itsNairr/SAMI/deliverables/City of Kingston Presentation.pptx

## SAMI (Sidewalk Accessibility Monitoring and Inspection)

- October 14, 2026

Final Year Capstone

Chloe Cook, Toby Copeland, Hari Nair, and Hannah Vibien


## What is SAMI?

1. Unmanned, autonomous rover that navigates sidewalks and pathways in a set route
2. Primarily focus on detecting cracks and uneven elevation issues.


Autonomous navigation

Collision avoidance

Inspection and reporting

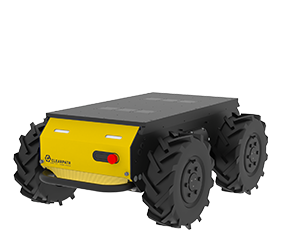
[picture p8: figure]
Husky Spec Comparison - Clearpath Robotics

## Overview of the Robot

Sensors:
- Huskey A200 Robot
- 2D SICK LiDAR
- RealSense depth camera (Front and Down)
- IMU (Inertial Measurement Unit)
- GPS
- Onboard computer
Features:
- Flag for visual awareness
- Speaker for audible awareness
- QR code for more information

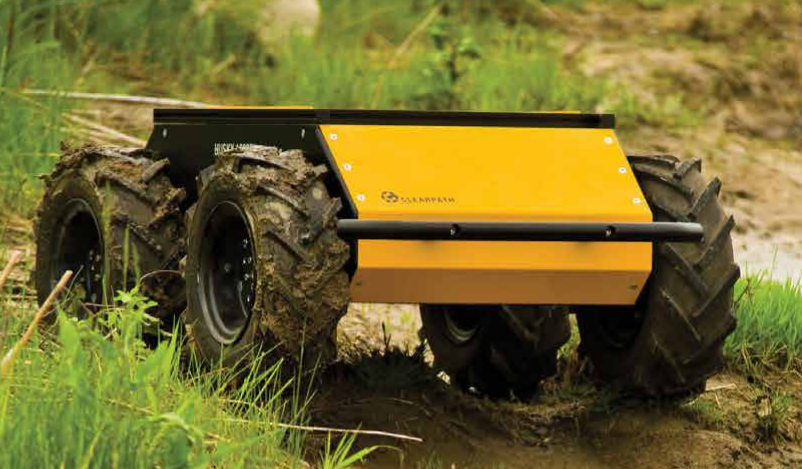
[picture p9: figure]

Does the City of Kingston track/save past workorders of sidewalk repair?
Is there any data we can use to test/train inspection camera?

## Current Inspection Priorities

Priority from Queen’s facilities
  - Cracks/Damage to sidewalks
  - Uneven elevation of sidewalk slabs
  - Damage to TWSI
  - Yearly check of Ramp elevation (after winter)
  - One time check of presence/dimensions of TWSI
  - One time check of width of pathways
  - One time check of presence of different materials along edges of paths and ramps

- What are the priorities of the City of Kingston?
- Are there any additional inspection items we have not considered?

## Reporting

Would overlaying data and GPS locations onto a map like this be useful? Or do you prefer a text file style of reporting?

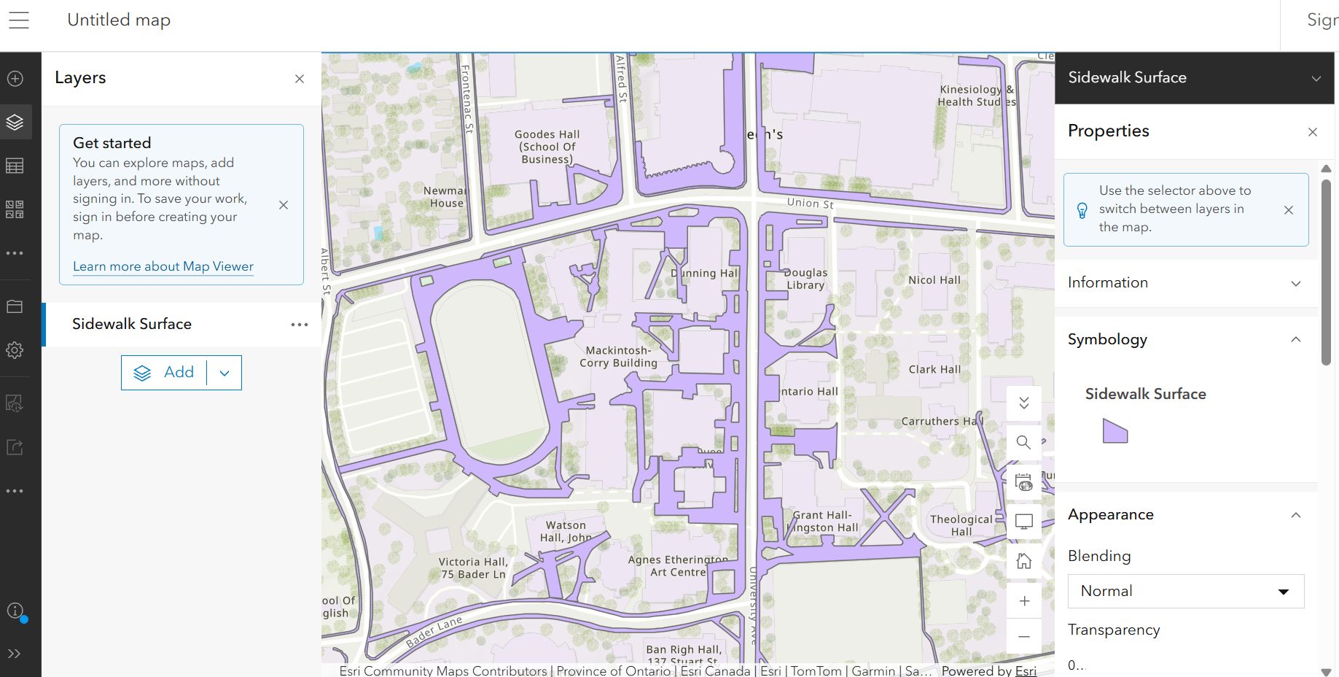
[picture p10: figure]

## Slide 6

## Overview of the Robot

- Huskey A200 Robot
- 2D SICK LiDAR
- RealSense depth camera (Front and down)
- IMU (Inertial Measurement Unit)
- GPS
- Onboard computer

## Navigation

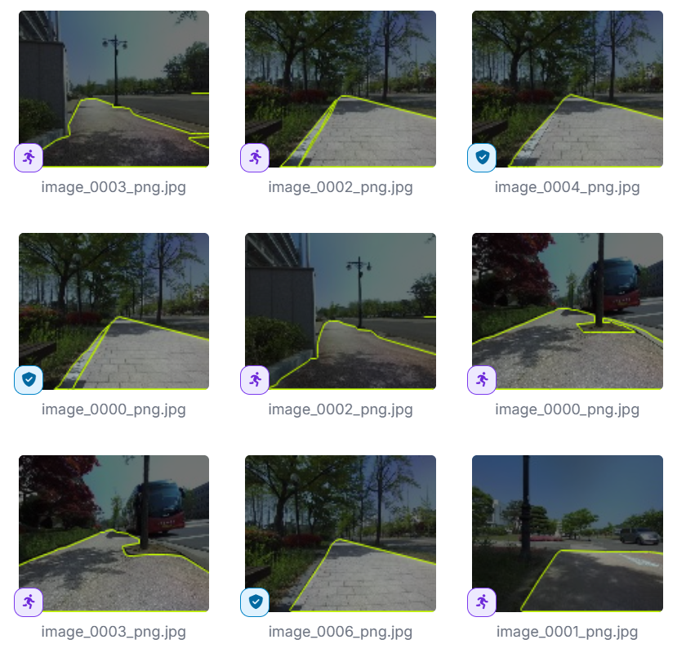
[picture p11: figure]

## Inspection System- Crack detection

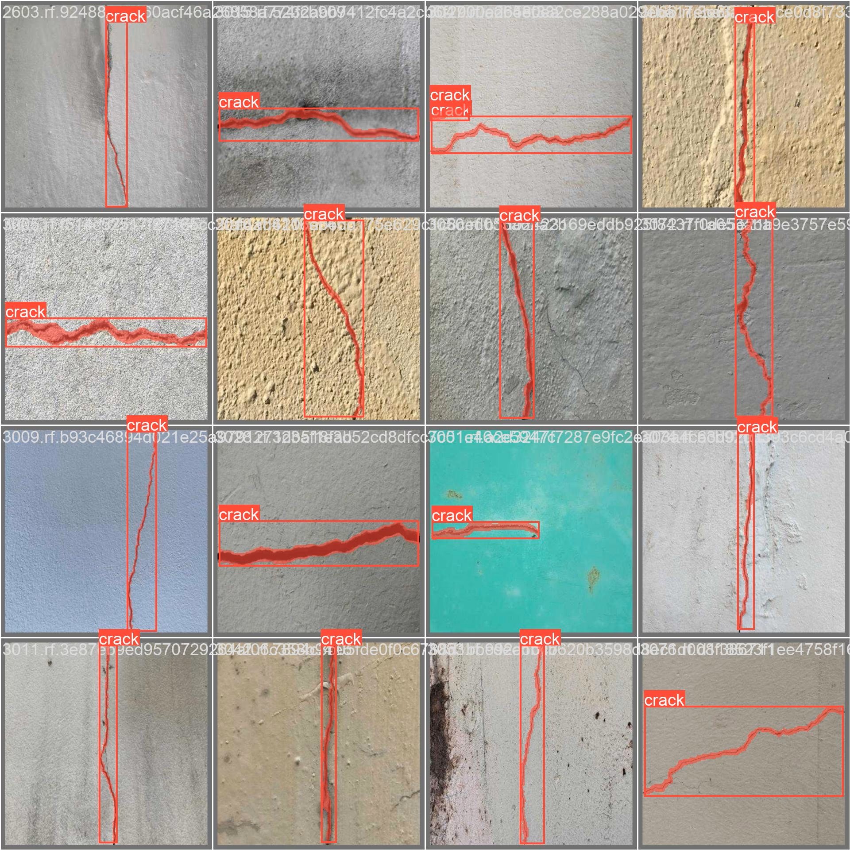
[picture p12: figure]
Crack segmentation dataset sample for infrastructure inspection

Mounted at 45* downwards facing

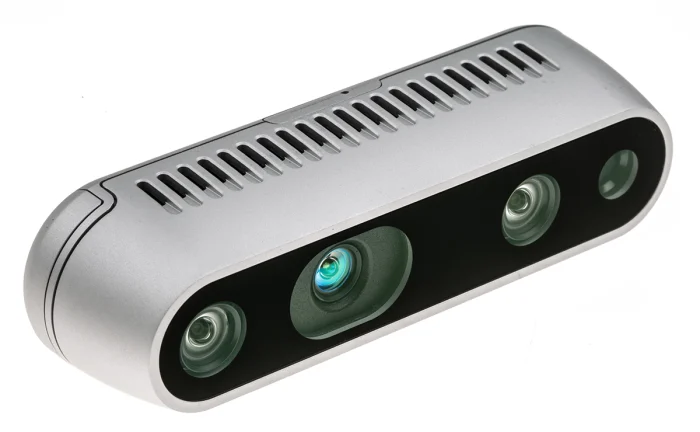
[picture p13: figure]
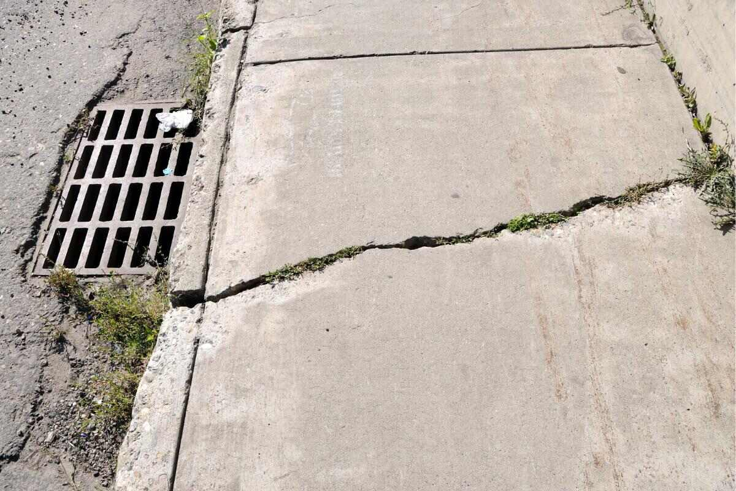
[picture p14: figure]

## Table Page

Tactic | Estimated Costs | Notes
Sub-category
Lorem ipsum dolor sit | $1,000.00 | Lorem ipsum dolor sit amet.
Lorem ipsum dolor sit | $1,000.00 | Lorem ipsum dolor sit amet, consectetur adipiscing elit, sed do eiusmod tempor incididunt ut labore et dolore magna aliqua.
Lorem ipsum dolor sit | $1,000.00 | Lorem ipsum dolor sit amet.
Lorem ipsum dolor sit | $1,000.00 | Lorem ipsum dolor sit amet.
Lorem ipsum dolor sit | $1,000.00 | Lorem ipsum dolor sit amet.
Lorem ipsum dolor sit | $1,000.00 | Lorem ipsum dolor sit amet, consectetur adipiscing elit, sed do eiusmod tempor incididunt ut labore et dolore magna aliqua.
Lorem ipsum dolor sit | $1,000.00 | Lorem ipsum dolor sit amet.
Subtotal | $9,000.00
15% fee | $1,350.00
Total | $10,350.00
