itsNairr/SAMI/notes/Goals Week 2.docx

# Goals

## Weekly

Look at simulations

Make scope and reach goals

Try and separate into sub roles

## Next week

Look into setting up testing area

# Mobility:

Get it to move

Move around and get back home (gps testy idk)

Navigate through non moving objects (lidar)

Navigate through dynamic objects (people)

Teach and repeat

# Vision:

Identify cracks

Distinguish between bad cracks and regular crack between 2 slabs

Identify ramp

D435 realsense

Navigation:

Identify the curbs

- Don’t drive off the curb
- Distinguish between like the curb when at intersection and elevation problem with curb

Path choice where should it go next

- Give it set gps locations to

Communication:

Store the problem locations locally

Send photos of problems with gps location back to a hub for facilities awareness

Update that map thing we found

Change in elevation of sidewalk – need to ask how much change is considered bad (accelerometer)

Assasibility problems

- Worn down markings at intersections (blind people?)
- Large cracks are tripping hazards
- Issues with ramps (closed, damage)
- Unexpected blockage on sidewalk (branches, boxes, garbage)

2d lidar or 3d?

Valedine

Sick lms111 he has 4 or 3 of those long range
