itsNairr/SAMI/notes/ClientMeetings/Sept 22 Accessibility Meeting.docx

Topics for meeting with Queen’s Facilities:

1. Explain our project, the purpose behind why we do capstone and what we want out the experience. Also that we need to create a scope.
2. Ask them to explain their job, so we can see how our project relates

Questions:

1. How do you determine if something on campus needs a repair?
2. Do you have a work order history, or any data on campus outdoor accessibility that could be useful for us?
3. What would you want to see in the scope for the project? What should we focus on?
4. Do you have a contact with the city of Kingston we could also talk too?

Meeting notes:

- Pathways, cracks in sidewalk, tactile strips, measure the length of tactile strip, level surfaces, debris (may not be able to fix it but can communicate it out to students)
- Paths that connect parking lots, and ramps incline (one time check) or once a year
- Priority pathways – will provide us with information
- Study done by geography students project, but observation based
- QFAS has standards we can use
- Most info comes in through email, they do not have a work order log
- Planning and renovation form, directed for issues and sidewalk issues
- There are different textures on the side of sidewalks and ramps
- Need it to be quite visible, add sound, and label on what it does
- QR code for more info on the Robot
- Robot insta account?
- Detecting snow in the winter? In case it does not get cleared out.
- Changes in elevation, what can get caught so cracks would be part of it.
- Crack→ cane could get stuck or wheels could get suck, or walkers
