itsNairr/SAMI/design/Mechanical/IntialConfiguationDrawingv1.png

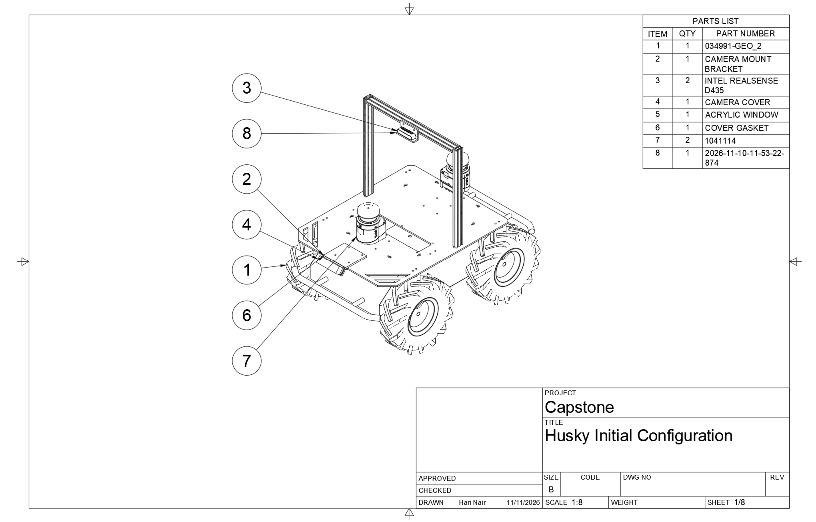
design/Mechanical/IntialConfiguationDrawingv1.png
