itsNairr/SAMI/deliverables/SAMIRiskRegister.xlsx

Sheet: EXAMPLE Risk Register
Risk Register Template Example
 |  |  |  |  |  |  | Auto-calculates
Risk ID | Risk | Risk Owner | Risk Trigger | Risk Category | Impact Level Rate 1 (LOW) to 5 (HIGH) | Probability Level Rate 1 (LOW) to 5 (HIGH) | Priority Level Impact x Probability Address the highest first. | Consequence Without Action | Positive Risk Response | Negative Risk Response | Response Trigger | Response Owner | Response Description | Expected Response | Status | Date Identified | Last Reviewed
RSK-001 | Delay in supplier shipment | Alexandra Mattson | Late delivery from the vendor | Operational | 4 | 4 | 16 | Missed client deadline | Enhance | Mitigate | Order delay notification | Brian Gorman | Reroute via alt distributor | Reduced project delay | Under Review | MM/DD/YY | MM/DD/YY
RSK-002 | Failure in a backup system | Aviv Perez | Weekly failover test | Technical | 4 | 4 | 16 | Outage during peak use | Share | Avoid | Test result report | Carmen Robertson | Switch to cloud redundancy | No downtime risk | Response in Progress | MM/DD/YY | MM/DD/YY
RSK-003 | Shift in market pricing | Brian Gorman | Competitor price drop | Strategic | 4 | 4 | 16 | Lost revenue margin | Exploit | Transfer | Pricing model trigger | Everett Crosse | Dynamic pricing algorithm | Gain on new accounts | Monitoring | MM/DD/YY | MM/DD/YY
RSK-004 | Lack of team certification | Brooklyn Jansen | Compliance audit finding | Compliance | 4 | 4 | 16 | Failed audit outcome | Accept | Accept | Quarterly audit report | Fiorella Fitzgerald | Schedule mandatory training | Certification compliance | Under Review | MM/DD/YY | MM/DD/YY
RSK-005 | A software update conflict | Carmen Robertson | Auto-patch failure | Technical | 4 | 4 | 16 | System freeze or rollback | Enhance | Transfer | Patch conflict log | Diana Kennedy | Isolate update in staging | Fewer incident reports | Response in Progress | MM/DD/YY | MM/DD/YY
RSK-006 | Inconsistent project estimates | Devon Gomez | Milestone planning gaps | Project | 4 | 4 | 16 | Timeline drift | Share | Mitigate | Scope change request | Alexandra Mattson | Implement the revised PERT method | Improved forecast | Under Review | MM/DD/YY | MM/DD/YY
RSK-007 | Contractor liability clause gap | Diana Kennedy | Contract review audit | Compliance | 4 | 4 | 16 | Uninsurable loss | Accept | Mitigate | Contract clause flagged | Aviv Perez | Legal review and reissue | Reduced legal exposure | Response in Progress | MM/DD/YY | MM/DD/YY
RSK-008 | No fallback for power outage | Everett Crosse | Generator servicing missed | Operational | 4 | 4 | 16 | Downtime in production | Enhance | Mitigate | Maintenance log | Hazel Christensen | Install a backup battery bank | Uptime maintained | Response in Progress | MM/DD/YY | MM/DD/YY
RSK-009 | Data sync error in reports | Fiorella Fitzgerald | ETL job failure | Technical | 4 | 4 | 16 | Incorrect business KPIs | Exploit | Avoid | Error threshold alert | Devon Gomez | Audit data pipeline | Accurate dashboards | Monitoring | MM/DD/YY | MM/DD/YY
RSK-010 | Unclear vendor responsibilities | Guadalupe Garcia | Multi-vendor project | Project | 4 | 4 | 16 | Gaps in service delivery | Accept | Accept | SLA mismatch alert | Henry McNeal | Align SOW with vendors | Higher accountability | Under Review | MM/DD/YY | MM/DD/YY
RSK-011 | A breach in access controls | Hazel Christensen | Role-based permissions gap | Cyber | 4 | 4 | 16 | User access violations | Accept | Mitigate | RBAC policy update | Brooklyn Jansen | Enforce privilege audit | Limit data exposure | Escalated | MM/DD/YY | MM/DD/YY
RSK-012 | Recurring absences from the team | Henry McNeal | Pattern in time logs | Operational | 4 | 4 | 16 | Delay in deliverables | Share | Transfer | HR absence report | Guadalupe Garcia | Adjust workload allocation | Output normalized | Closed | MM/DD/YY | MM/DD/YY
RSK-013 | Late internal approvals | Alexandra Mattson | Stalled decision point | Project | 4 | 4 | 16 | Missed the go-live milestone | Accept | Avoid | Change request aging | Fiorella Fitzgerald | Implement approval SLAs | Phase control gained | Monitoring | MM/DD/YY | MM/DD/YY
RSK-014 | Overage in the budget forecast | Aviv Perez | Forecast variance report | Strategic | 4 | 4 | 16 | Project pause or scope cut | Enhance | Mitigate | Budget update trigger | Diana Kennedy | Add a contingency buffer | Prevent overruns | Under Review | MM/DD/YY | MM/DD/YY
RSK-015 | Error in legal disclaimers | Brian Gorman | Final draft review | Compliance | 4 | 4 | 16 | Regulatory pushback | Accept | Mitigate | Legal signoff alert | Carmen Robertson | Rewrite disclaimers | Cleared before launch | Response in Progress | MM/DD/YY | MM/DD/YY
RSK-016 | Deviation from a safety plan | Brooklyn Jansen | Field inspection flag | Operational | 4 | 4 | 16 | On-site injury risk | Share | Mitigate | Safety form check | Hazel Christensen | Retrain crew lead | Lower incident rate | Response in Progress | MM/DD/YY | MM/DD/YY
RSK-017 | Out-of-date contact list | Carmen Robertson | Escalation issue | Operational | 4 | 4 | 16 | Slow incident response | Accept | Avoid | Failed contact test | Everett Crosse | Sync with HR records | Faster alerting | Closed | MM/DD/YY | MM/DD/YY
RSK-018 | Missed GDPR reconsent window | Devon Gomez | Policy update deadline | Compliance | 4 | 4 | 16 | Data breach penalties | Enhance | Transfer | Regulation deadline alert | Fiorella Fitzgerald | Deploy email reconsent | Lower legal risk | Escalated | MM/DD/YY | MM/DD/YY
RSK-019 | Use of deprecated toolset | Diana Kennedy | Legacy asset list | Technical | 4 | 4 | 16 | Security or feature gaps | Exploit | Mitigate | IT deprecation report | Brian Gorman | Shift to the supported version | Improved ops stability | Monitoring | MM/DD/YY | MM/DD/YY
RSK-020 | Duplicate data entry workflow | Everett Crosse | Form structure conflict | Operational | 4 | 4 | 16 | Processing delays | Enhance | Avoid | Data QA check | Guadalupe Garcia | Revise submission logic | Higher process speed | Response in Progress | MM/DD/YY | MM/DD/YY
RSK-021 | A high turnover rate | Fiorella Fitzgerald | Monthly HR report | Strategic | 4 | 4 | 16 | Project continuity gaps | Accept | Mitigate | Attrition threshold hit | Alexandra Mattson | Exit interview program | Lower churn | Identified | MM/DD/YY | MM/DD/YY
RSK-022 | Misaligned KPIs with partner | Guadalupe Garcia | Dashboard review | Strategic | 4 | 4 | 16 | Strained collaboration | Share | Mitigate | KPI sync session | Henry McNeal | Align metrics to objectives | Better reporting cohesion | Identified | MM/DD/YY | MM/DD/YY
RSK-023 | Broken escalation protocol | Hazel Christensen | Incident report feedback | Operational | 4 | 4 | 16 | Delayed resolution | Enhance | Accept | Escalation audit | Aviv Perez | Define roles in SOP | Streamlined handling | Response in Progress | MM/DD/YY | MM/DD/YY
RSK-024 | Lack of visibility into backlog | Henry McNeal | Sprint review outcome | Project | 4 | 4 | 16 | Under-scoped resource need | Share | Transfer | Ticket volume alert | Brooklyn Jansen | Improve backlog grooming | Better sprint flow | Monitoring | MM/DD/YY | MM/DD/YY
RSK-025 | License renewal window missed | Alexandra Mattson | Vendor billing cycle | Compliance | 4 | 4 | 16 | Suspended service use | Accept | Mitigate | Renewal deadline ping | Carmen Robertson | Centralize license tracker | Continuous access | Monitoring | MM/DD/YY | MM/DD/YY
RSK-026 | Outdated disaster recovery plan | Aviv Perez | Quarterly IT audit | Compliance | 4 | 4 | 16 | Failed continuity test | Accept | Avoid | DR policy review | Everett Crosse | Update response procedures | Reduced recovery lag | Monitoring | MM/DD/YY | MM/DD/YY
RSK-027 | The use of unapproved tools | Brooklyn Jansen | Shadow IT detection | Cyber | 4 | 4 | 16 | Data exfiltration risk | Share | Mitigate | Unauthorized app flag | Guadalupe Garcia | Create an approved tool registry | Increased security | Monitoring | MM/DD/YY | MM/DD/YY
RSK-028 | incomplete change request form | Carmen Robertson | Process deviation log | Operational | 4 | 4 | 16 | Rollback or delay | Enhance | Transfer | Form validation trigger | Alexandra Mattson | Add required field checks | Fewer rejections | Identified | MM/DD/YY | MM/DD/YY
RSK-029 | Missed stakeholder feedback | Diana Kennedy | Design review skipped | Project | 4 | 4 | 16 | Product misalignment | Exploit | Avoid | Feedback phase missed | Hazel Christensen | Add approval gate | Better user fit | Mitigation Complete | MM/DD/YY | MM/DD/YY
RSK-030 | Security log retention issue | Everett Crosse | SIEM alert for deletion | Cyber | 4 | 4 | 16 | Non-compliance with the audit | Accept | Accept | Log threshold alert | Brian Gorman | Increase the log window to 180 days | Meets retention standard | Response in Progress | MM/DD/YY | MM/DD/YY
RSK-031 | Limited mobile access to reports | Fiorella Fitzgerald | Field team complaint | Operational | 4 | 4 | 16 | Reduced field productivity | Enhance | Mitigate | Mobile access gap noted | Diana Kennedy | Optimize mobile dashboards | Improved responsiveness | Response in Progress | MM/DD/YY | MM/DD/YY
RSK-032 | Miscommunication in task assignment | Guadalupe Garcia | Conflicting instructions | Project | 4 | 4 | 16 | Rework and confusion | Share | Mitigate | Task reassignment log | Brooklyn Jansen | Implement task clarity SOP | Smoother handoffs | Response in Progress | MM/DD/YY | MM/DD/YY
RSK-033 | Unclear ownership in escalation | Hazel Christensen | Incident report review | Operational | 4 | 4 | 16 | Delayed recovery process | Accept | Transfer | Unclear escalation contact | Aviv Perez | Assign ownership tiers | Faster issue resolution | Identified | MM/DD/YY | MM/DD/YY
RSK-034 | An unverified vendor invoice | Henry McNeal | AP exception report | Compliance | 4 | 4 | 16 | Overpayment or fraud | Accept | Mitigate | Invoice not linked to PO | Carmen Robertson | Enforce 3-way match policy | Lower fraud risk | Escalated | MM/DD/YY | MM/DD/YY
RSK-035 | Underestimation of testing time | Alexandra Mattson | Sprint planning gap | Project | 4 | 4 | 16 | Missed delivery date | Enhance | Mitigate | Planning error in testing hours | Fiorella Fitzgerald | Add test padding in the timeline | On-time launches | Under Review | MM/DD/YY | MM/DD/YY
RSK-036 | Inaccurate tracking of expenses | Brian Gorman | Finance tool report | Strategic | 4 | 4 | 16 | Overspending risk | Accept | Avoid | Out-of-sync budget tool | Everett Crosse | Monthly reconciliation schedule | Tighter cost control | Under Review | MM/DD/YY | MM/DD/YY
RSK-037 | Lack of an escalation path in SOP | Brooklyn Jansen | Review of outdated doc | Operational | 4 | 4 | 16 | Resolution delay | Accept | Avoid | Missing contact info | Guadalupe Garcia | Update SOP with levels | Improved response speed | Identified | MM/DD/YY | MM/DD/YY
RSK-038 | The use of default system passwords | Diana Kennedy | Pen test finding | Cyber | 4 | 4 | 16 | Unauthorized access | Accept | Avoid | Default password detected | Alexandra Mattson | Enforce password policy | Reduced breach risk | Mitigation Complete | MM/DD/YY | MM/DD/YY
RSK-039 | A lack of onboarding documentation | Everett Crosse | New hire feedback | Operational | 4 | 4 | 16 | Slow ramp-up | Enhance | Accept | Onboarding checklist gap | Henry McNeal | Build quick-start docs | improved productivity | Identified | MM/DD/YY | MM/DD/YY
RSK-040 | Failure to back up the shared drive | Fiorella Fitzgerald | Backup alert email | Technical | 4 | 4 | 16 | Permanent data loss | Share | Mitigate | Backup skipped 3 days | Brian Gorman | Schedule daily cloud backups | Data recovery ensured | Identified | MM/DD/YY | MM/DD/YY
CLICK HERE TO CREATE IN SMARTSHEET (https://www.smartsheet.com/try-it?trp=12400)

Sheet: Scale and Key
RISK REGISTER SCALE
P R O B A B I L I T Y | 5 | 5 | 10 | 15 | 20 | 25 | Status | Positive Risk Response | Negative Risk Response | LEVEL
 | 4 | 4 | 8 | 12 | 16 | 20 | Identified | Accept | Accept | 1
 | 3 | 3 | 6 | 9 | 12 | 15 | Response in Progress | Enhance | Mitigate | 2
 | 2 | 2 | 4 | 6 | 8 | 10 | Mitigation Complete | Share | Transfer | 3
 | 1 | 1 | 2 | 3 | 4 | 5 | Monitoring | Exploit | Avoid | 4
 |  | 1 | 2 | 3 | 4 | 5 | Escalated |  |  | 5
 |  | I M P A C T |  |  |  |  | Closed
 |  |  |  |  |  |  | Under Review

Sheet: SAMI Risk Register
SAMI Risk Register
 |  |  |  |  |  |  | Auto-calculates
Risk ID | Risk | Risk Owner | Risk Trigger | Risk Category | Impact Level Rate 1 (LOW) to 5 (HIGH) | Probability Level Rate 1 (LOW) to 5 (HIGH) | Priority Level Impact x Probability Address the highest first. | Consequence Without Action | Positive Risk Response | Negative Risk Response | Response Trigger | Response Owner | Response Description | Expected Response | Status | Date Identified | Last Reviewed | KEY
1 | Collisions |  | YOLO doesn't identify a person with the front camera | Safety | 5 | 4 | 20 | Injury to pedestrians or property damage |  |  |  |  |  |  |  |  |  | LEVEL
2 | Losing path, being unable to return |  | Loss of GPS signal and IMU data and camera not being able to identify the path (GPS Multipath) | Technical | 5 | 3 | 15 |  |  |  |  |  |  |  |  |  |  | 1
3 | Water getting in electronics |  | Unexpected weather and/or water sources | Operational | 5 | 2 | 10 | Sensors and/or any electronics get damaged |  |  |  |  |  |  |  |  |  | 2
4 | Inaccurate Sensor Data |  | Latency or programmed incorrectly. Ex: truck casting shadow on a crack , looking twice or needing a percetnage threshold | Technical | 3 | 2 | 6 |  |  |  |  |  |  |  |  |  |  | 3
5 | Report corrupted |  |  | Technical |  |  |  | save copes in 2 spot and data backup |  |  |  |  |  |  |  |  |  | 4 | gps multipath
6 | Purposeful damage to the SAMI |  | Abused by public | Operational |  |  |  | Make community aware of positive benefits of SAMI |  |  | Make community aware of positive benefits of SAMI |  |  |  |  |  |  | 5
7 | Social protests against SAMI |  | Social/community rejection | Social | 3 | 3 | 9 | Speak to community in advance provide information
8 | Everyone gets sick |  | Virus | Operational | 4 | 1 | 4 | Work gets delayed and deadlines are missed
 |  |  | talk to community, talk to neighbourhood, have a public presence, enure that the purpuse is clear, we are trying to help improve humans space, not just take up there space like uber sidewalk robot s
 |  |  | be open to feedback from the community

Sheet: - Disclaimer -
Any articles, templates, or information provided by Smartsheet on the website are for reference only. While we strive to keep the information up to date and correct, we make no representations or warranties of any kind, express or implied, about the completeness, accuracy, reliability, suitability, or availability with respect to the website or the information, articles, templates, or related graphics contained on the website. Any reliance you place on such information is therefore strictly at your own risk.
