itsNairr/SAMI/design/Mechanical/IntelRealsense_D435_Multibody.SLDPRT

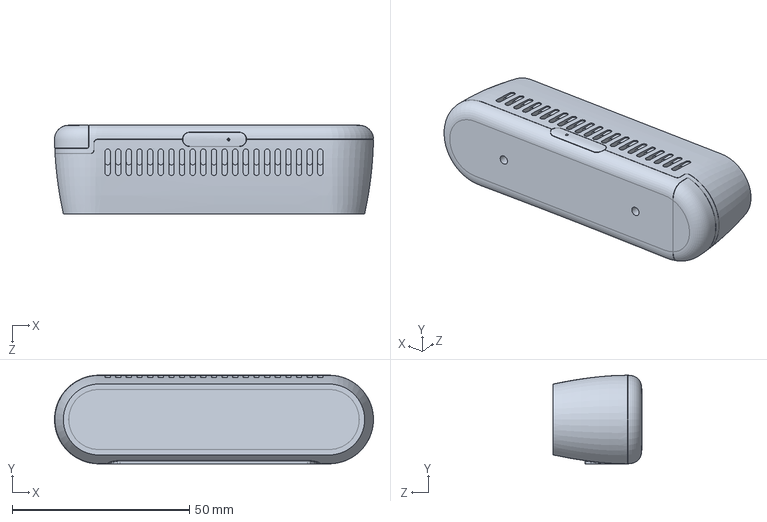
[picture p16: CAD file, 2026-11-12]
design/Mechanical/IntelRealsense_D435_Multibody.SLDPRT
90.0 x 25.0 x 25.0 mm
