itsNairr/SAMI/design/Mechanical/SICKLidar.stp

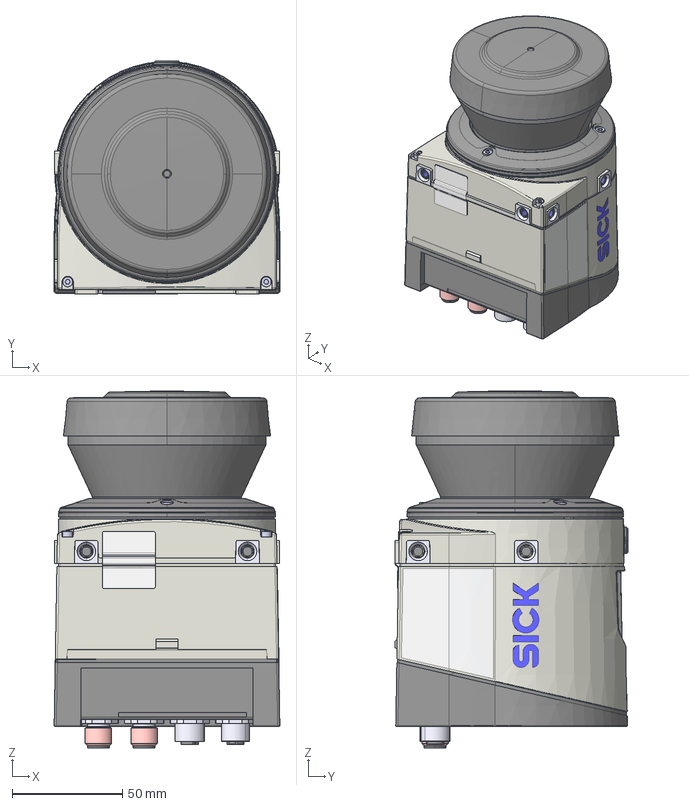
[picture p17: CAD file, 2026-11-12]
design/Mechanical/SICKLidar.stp
102.3 x 105.6 x 161.8 mm
