itsNairr/SAMI/design/Mechanical/HuskyA200.STEP

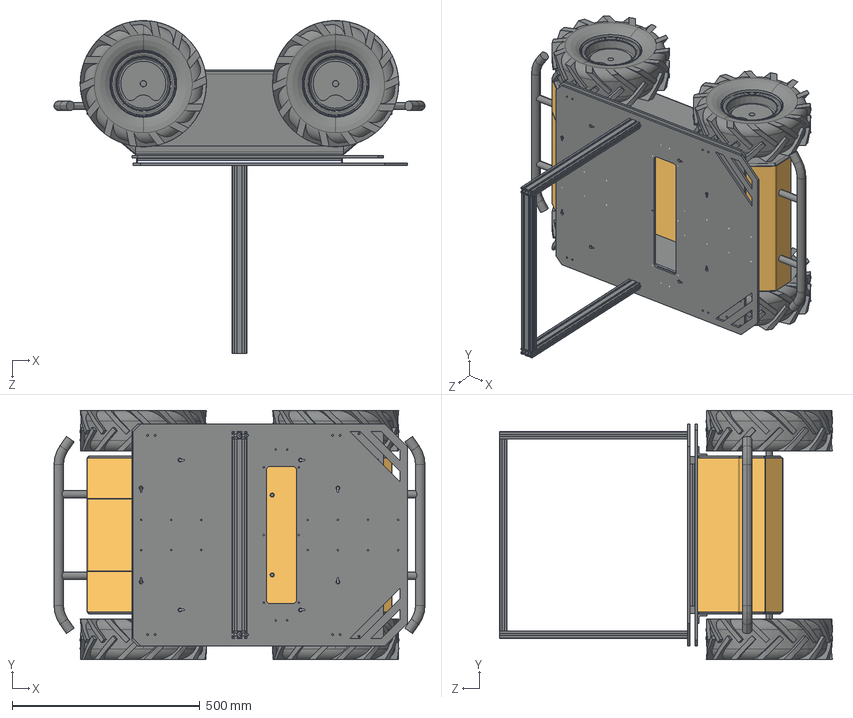
[picture p18: CAD file, 2026-11-05]
design/Mechanical/HuskyA200.STEP
987.4 x 663.0 x 885.8 mm
034991-CHASSIS_Simplified mCAD, STEP-Husky A200, Skid Steer
034991-LIVERY_Simplified mCAD, STEP-Husky A200, Skid Steer
034991-BUMPERS_Simplified mCAD, STEP-Husky A200, Skid Steer
034991-MOBILITY_Simplified mCAD, STEP-Husky A200, Skid Steer
034991-ELECTRONICS_Simplified mCAD, STEP-Husky A200, Skid Steer
034991-BATTERY_Simplified mCAD, STEP-Husky A200, Skid Steer
034991-TOP-PACS_Simplified mCAD, STEP-Husky A200, Skid Steer
034991-TOP-EXTRUSION_Simplified mCAD, STEP-Husky A200, Skid Steer
034991-TOP-STANDARD_Simplified mCAD, STEP-Husky A200, Skid Steer
