itsNairr/SAMI/Testing/Individual System/HuskyBase/Oct20RosCommandsHuskyConnection.docx

WSL USB COMMANDS

usbipd list

usbipd bind --busid 2-1

usbipd attach --wsl --busid 2-1

## Connecting to the robot:

source ~/ros2_ws/install/setup.bash #run once you open

cd ~/ros2_ws/src

git clone https://github.com/husky/husky.git -b humble-devel #run in src

cd ~/ros2_ws/src/husky/husky_description/urdf #go into file

dmesg | grep usb #use this to determine if USB0 or USB1

code . #open VSCode and change line 178 to dev/ttyUSB0</param> based on previous line

lsusb #display usb list WSL sees

cd ~/ros2_ws

colcon build #do before run in workspace (not in file)

sudo chmod 666 /dev/ttyUSB0 #connect to USB, or change to 1 if USB1

ros2 launch husky_base base.launch.py #launch program
