itsNairr/SAMI/Testing/Individual System/Simulation/Simulation.docx

# 1. Simulation Testing

## 1.1 Simulation Worlds

The current Gazebo simulation has been set up to use two different worlds for testing. The first is the Clearpath warehouse world which is used for testing sensors / sensor integration as well as driving with the safety stop object detection feature discussed below in section 1.2 Features. The second world includes a pier which is used due to its similarity to a sidewalk. This world is to be used for testing sidewalk and crack detecting model

## 1.2 Features

The current simulation features include keyboard control movement around the world, and object detection and stop using the forward facing camera. The forward camera uses depth to detect distance to an object and when it is within the given range it locks out the /cmd_vel ROS2 topic to remove drive access from the keyboard. This is done to test out stopping distances at different speeds.

## 1.3 Sensor Setup

The simulation to date includes two cameras, one facing 45 degrees downwards to detect and analyze cracks and one facing forward to detect obstructions and classify them. There is also a LiDAR connected to the top to view obstructions on a 2D plane. Inside the Husky there is also an IMU to determine orientation which is used for determining incline of sidewalks.

# 2. Future Steps

## 2.1 Worlds

Future steps for the worlds include creating a more realistic sidewalk world with real gaps to properly test crack detection.

## 2.2 Features

Camera node will be updated to match the current non simulation version of object person and person detection. This includes transferring the model the camera uses to detect when obstacle is a person. Future improvements to simulation should also include only preventing robot from moving forward when an obstacle is detected and allow it to move backwards otherwise it can get trapped in simulation.

## 2.3 Sensors

Future steps for the sensors include updating the current sensor positions. The simulation sensor positions are outdated and should be changed to match the current plan. The second LiDAR and GNSS, as well as their nodes should be added as well as their nodes to integrate them should be added as well.
