itsNairr/SAMI/Testing/Subsytems/Collision avoidance/Collision avoidance data 2026-11-11.xlsx

 |  | stopping distance was set to 0.5m in code.
speed (m/2) | stopping distance(m)
0.34 | 0.54
0.41 | 0.495
0.5 | 0.4066666667
0.61 | 0.3133333333 |  | 0.5 | 0.5
0.81 | 0.23 |  | 0 | 0.9
0.89 | hit the foam square could not get accurate measurements
differnce between expected and actual
0.04
-0.005 | -0.005
-0.09333333333 | -0.1
-0.1866666667 | -0.2
-0.27 | -0.3
Conclusion
As speed is increased by a factor of 10 the stopping distance multiplier must be increased by a factor of 10 as well to result in the expected stoping distance
