itsNairr/SAMI/Testing/Individual System/YOLOCrackDetection/November 10th Training & Test/results.csv

epoch | time | train/box_loss | train/seg_loss | train/cls_loss | train/l1_loss | train/sem_loss | metrics/precision(B) | metrics/recall(B) | metrics/mAP50(B) | metrics/mAP50-95(B) | metrics/precision(M) | metrics/recall(M) | metrics/mAP50(M) | metrics/mAP50-95(M) | val/box_loss | val/seg_loss | val/cls_loss | val/l1_loss | val/sem_loss | lr/pg0 | lr/pg1 | lr/pg2 | lr/pg3 | lr/pg4 | lr/pg5 | lr/pg6 | lr/pg7
1 | 93.4235 | 0.98665 | 1.73226 | 1.91144 | 0.01104 | 1.36668 | 0.86216 | 0.7241 | 0.78481 | 0.5495 | 0.86027 | 0.69755 | 0.75404 | 0.4273 | 1.31196 | 1.75532 | 1.30021 | 0.02474 | 0 | 0.00997015 | 0.00332338 | 0.00997015 | 0.00332338 | 0.00997015 | 0.00332338 | 0.00997015 | 0.00332338
2 | 160.187 | 0.97876 | 1.36418 | 0.92737 | 0.01131 | 0.76553 | 0.82601 | 0.67821 | 0.75132 | 0.48826 | 0.81385 | 0.67241 | 0.72413 | 0.40173 | 1.44727 | 1.47557 | 1.23525 | 0.03003 | 0 | 0.0198713 | 0.00662377 | 0.0198713 | 0.00662377 | 0.0198713 | 0.00662377 | 0.0198713 | 0.00662377
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
