itsNairr/SAMI/Testing/Individual System/YOLOCrackDetection/November 10th Training & Test/results.png

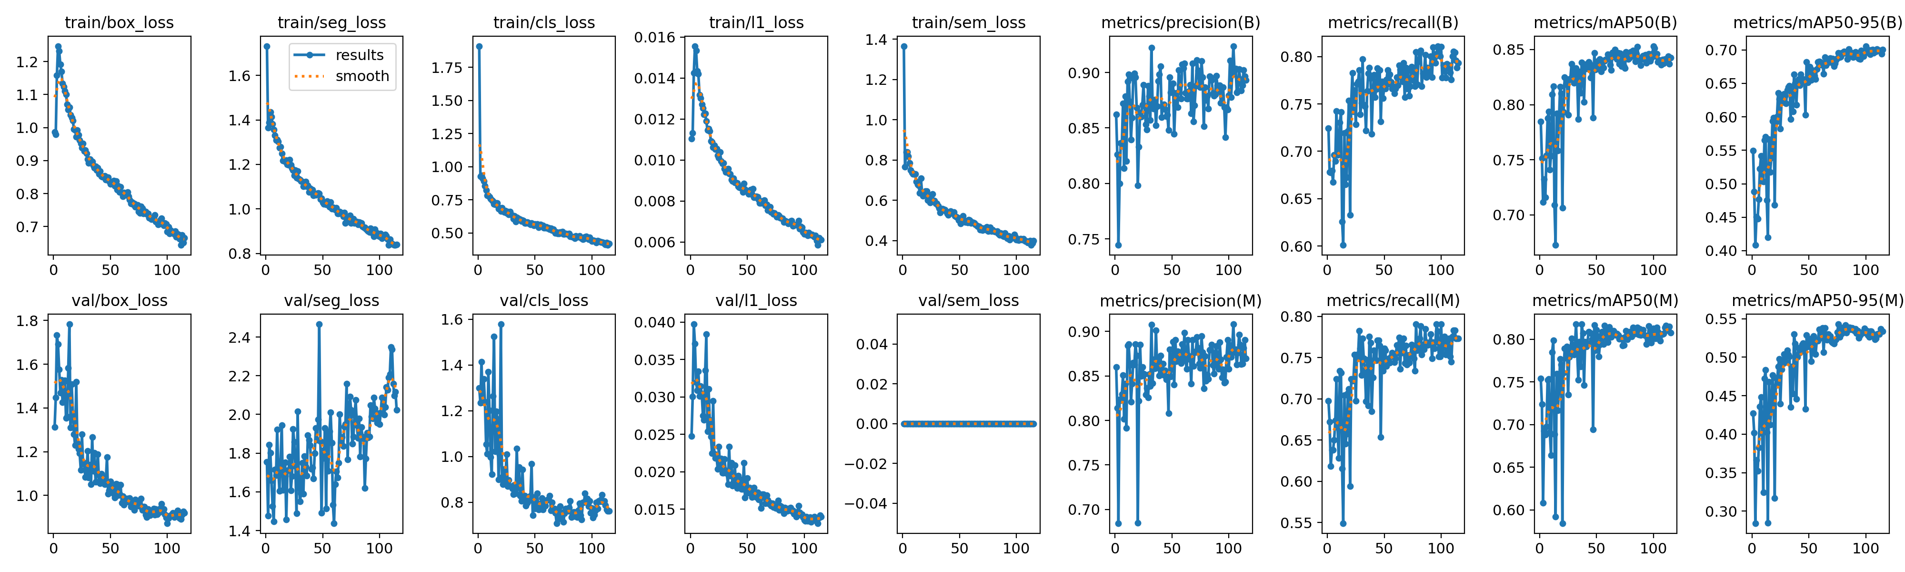
Testing/Individual System/YOLOCrackDetection/November 10th Training & Test/results.png
