itsNairr/SAMI/design/Electrical/PowerDistributionDiagramR1.pdf

31 | LIP.IE

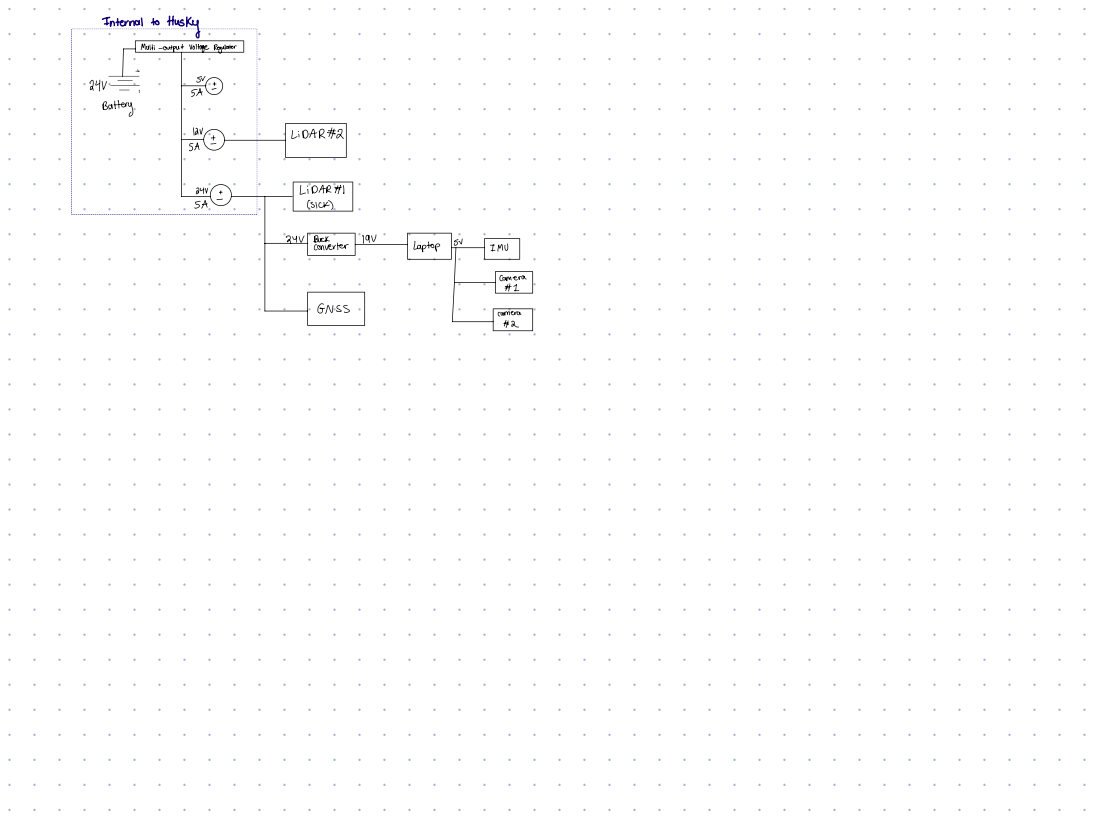
[picture p31: page 1]
Internal.itiitageresuator; battery; LIDAR 2; 24VByterter19V; Laptop so IMU; capyra; GNSS; carpet
