itsNairr/SAMI/design/Mechanical/InitialConfigCalculations.pdf

## Calculation Sheet

# Husky Downward Camera Mount

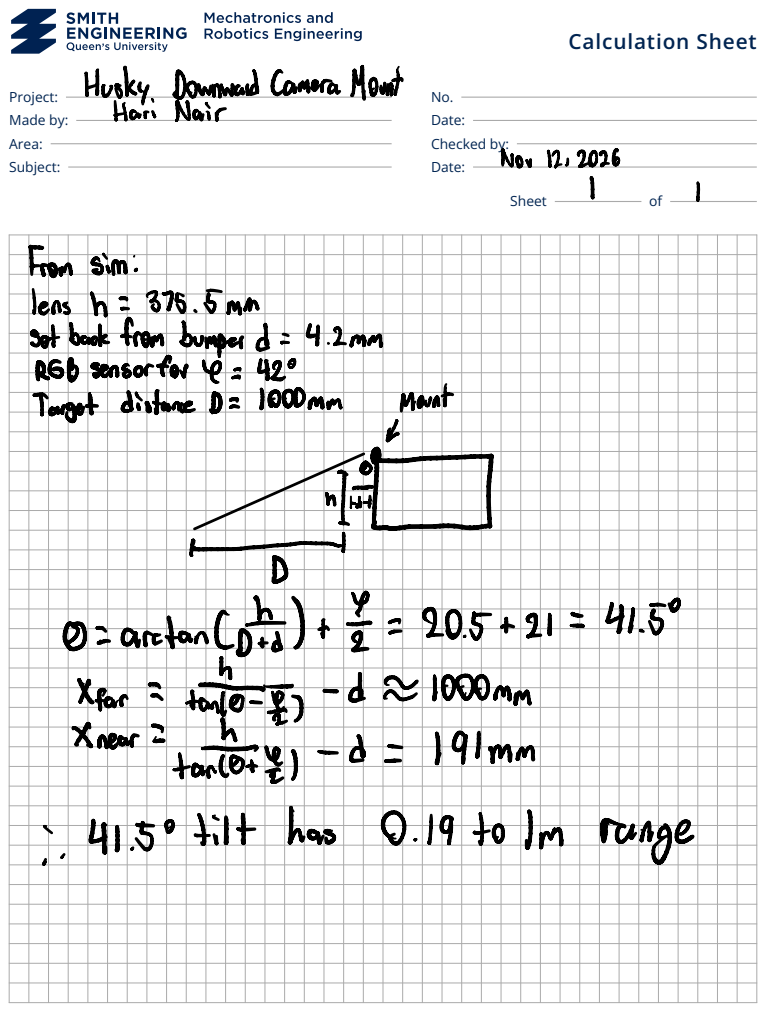
[picture p32: page 1]
Project:; Made by:; Date:; Area:; Checked by:; Subject:; Sheet; Hari Nair; Nov 12.; from; sim :; Xnear; tantox -; filt; has; range

lens | | h | = 375.5mm
set | back from | | | bumper d = | | | | 4 .2 mm
nT --1

&B | | sensorfor 4 | | | | : | 42
distance | | D = | | 1000mm | | | | Mount Target

O = arctan (0 | | | | | )芝 = | 20 | .5+ 2 に | 41 | .50

Xfar | : | fa-E-d¹⁰⁰⁰mm

## Calculation Sheet

# HuskyLidar Spaina

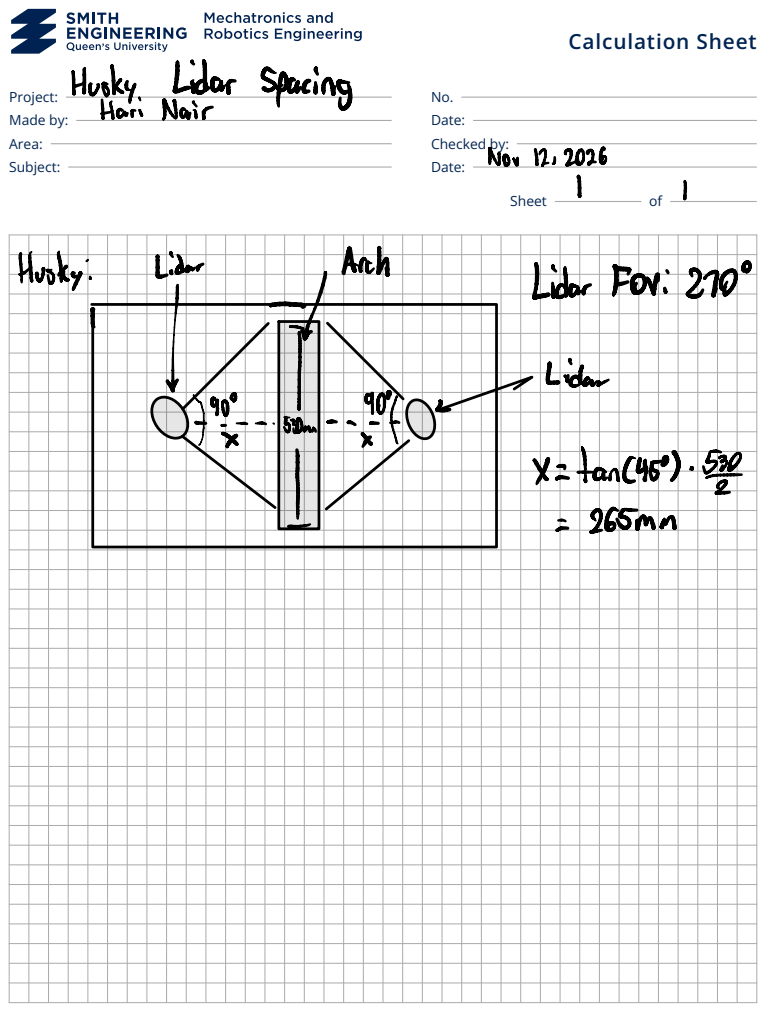
[picture p33: page 2]
Project:; Made by:; Date:; Area:; Checked by:; Subject:; Sheet; Nov 12.; Husky; Arch; Lidar; FOV:; ↳i-fncus.
