itsNairr/SAMI/Testing/Individual System/Camera/CameraDepthTesting_Sept25/CameraDepthTesterDrawing.pdf

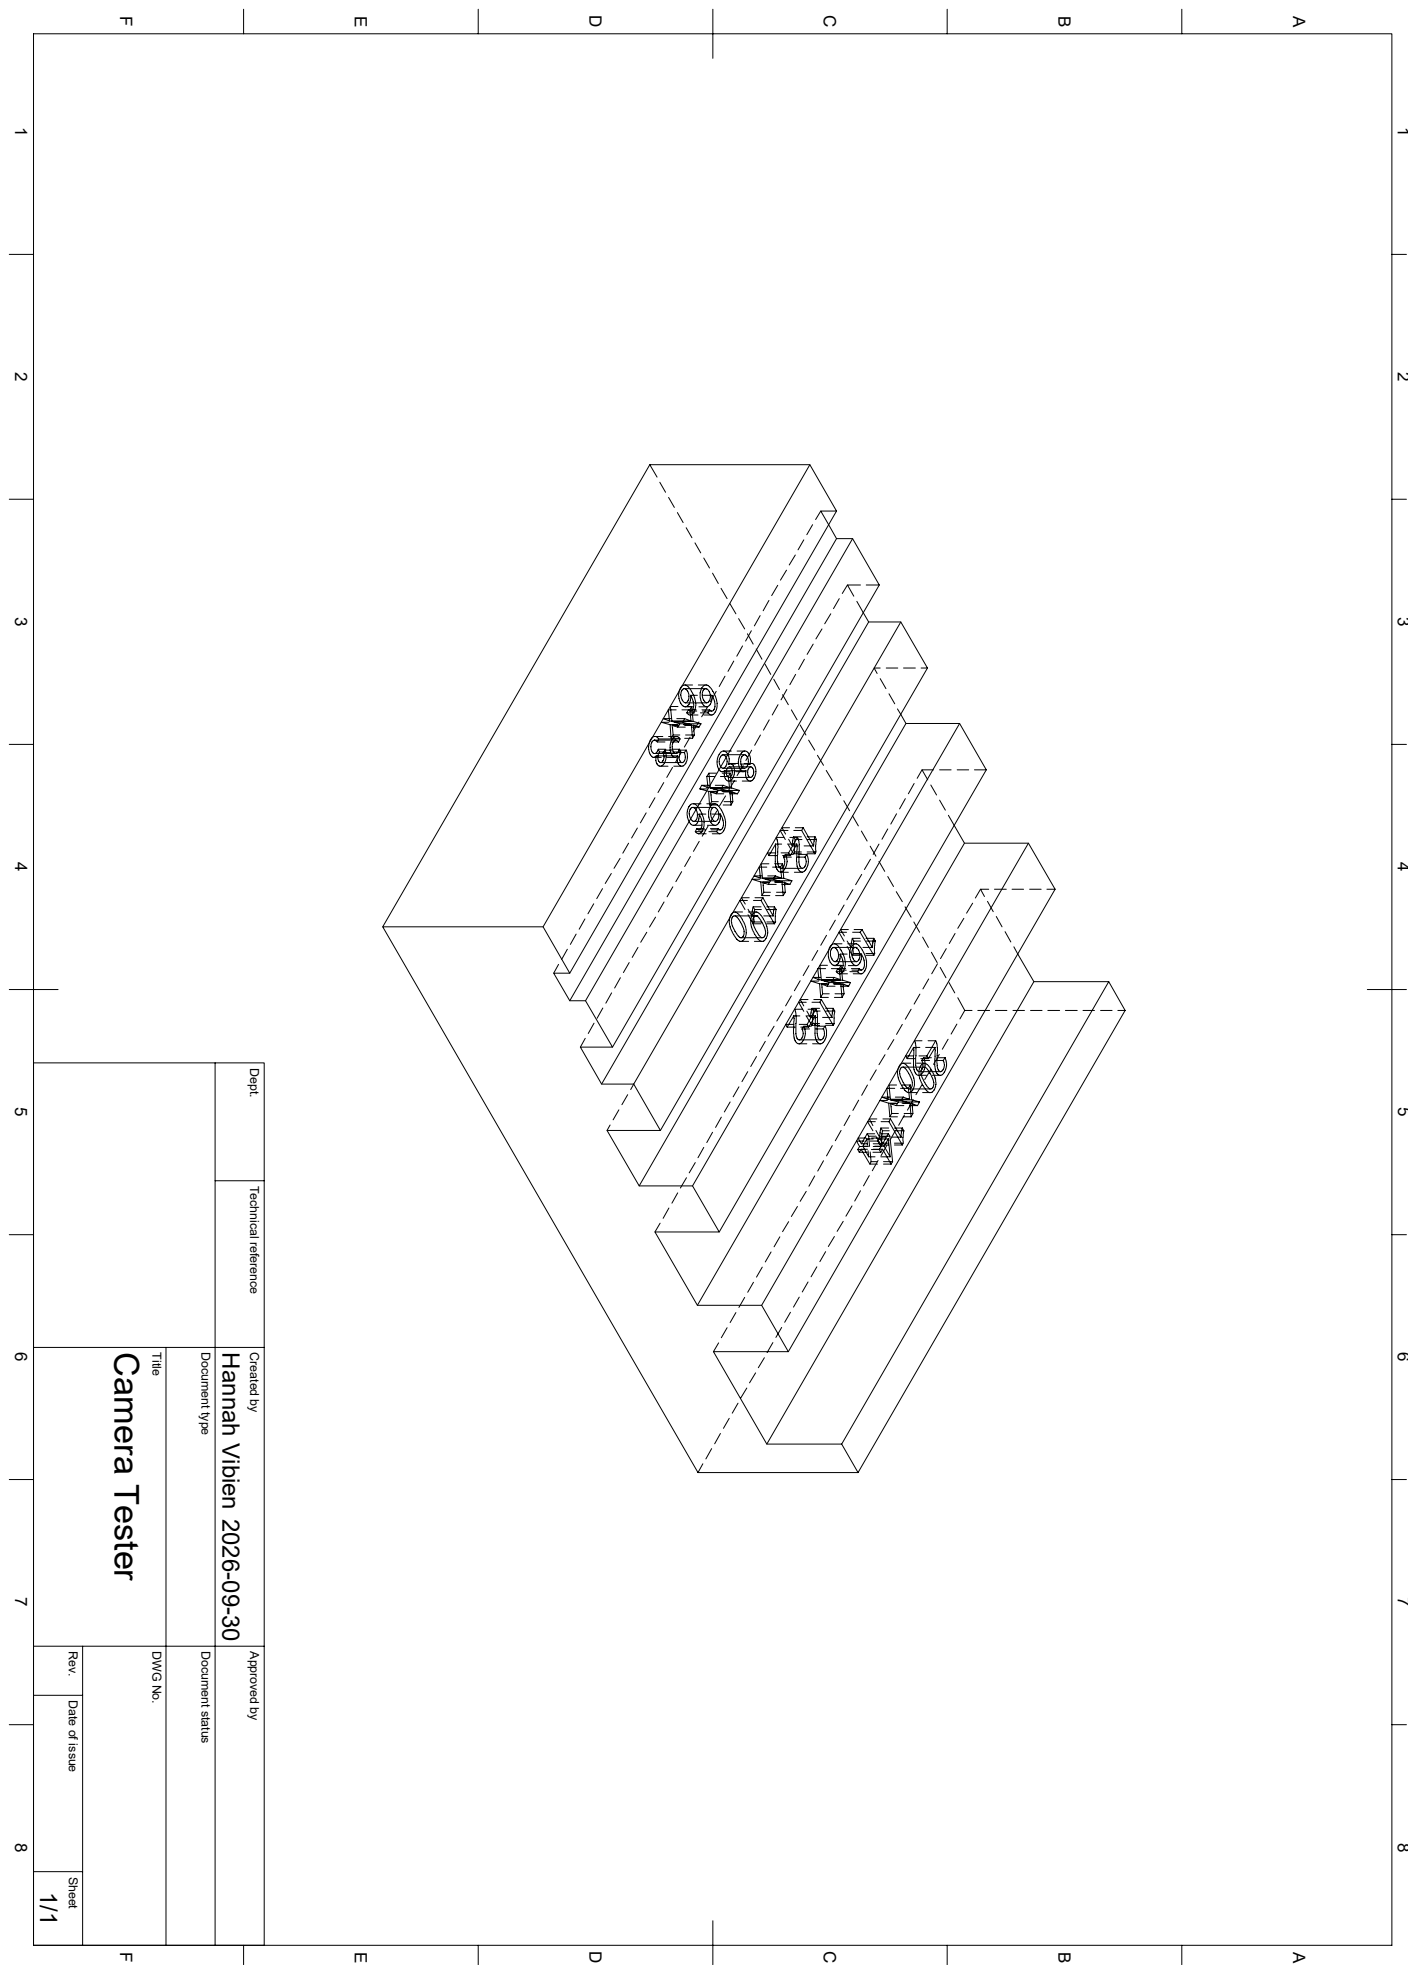
[picture p34: page 1]

1 A 2 3 4 5 6 7 8 1 2 3 4 5 6 7 8 FEDCB FEDCBA Dept. Technical reference Created by Approved by Title DWG No. Document type Document status Rev. Date of issue Sheet 2026-09-30 1/1 Camera Tester Hannah Vibien
