itsNairr/SAMI/design/Electrical/Calculations/Nov10LaptopBuckConverterCalculationSheet.pdf

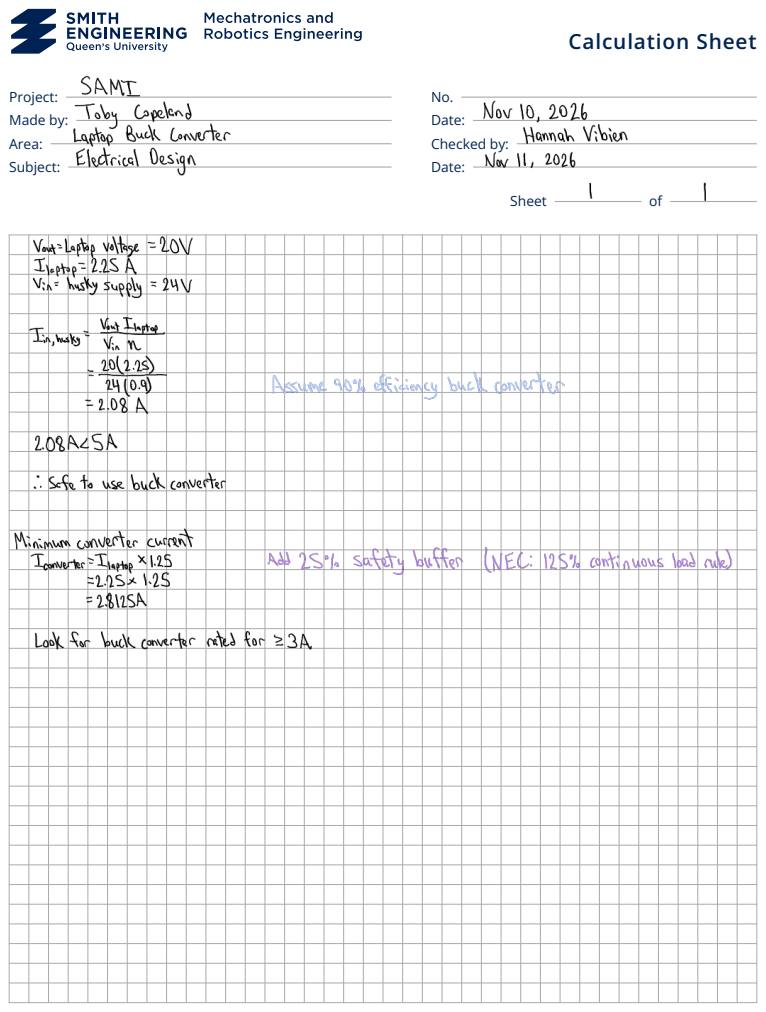
[picture p35: page 1]
Calculation Sheet; Project:; Made by:; Date:; Area:; Checked by:; Subject:; Sheet
