itsNairr/SAMI/design/Electrical/Calculations/Oct26LiDARCalculationSheet.pdf

## Calculation Sheet

## SAMI

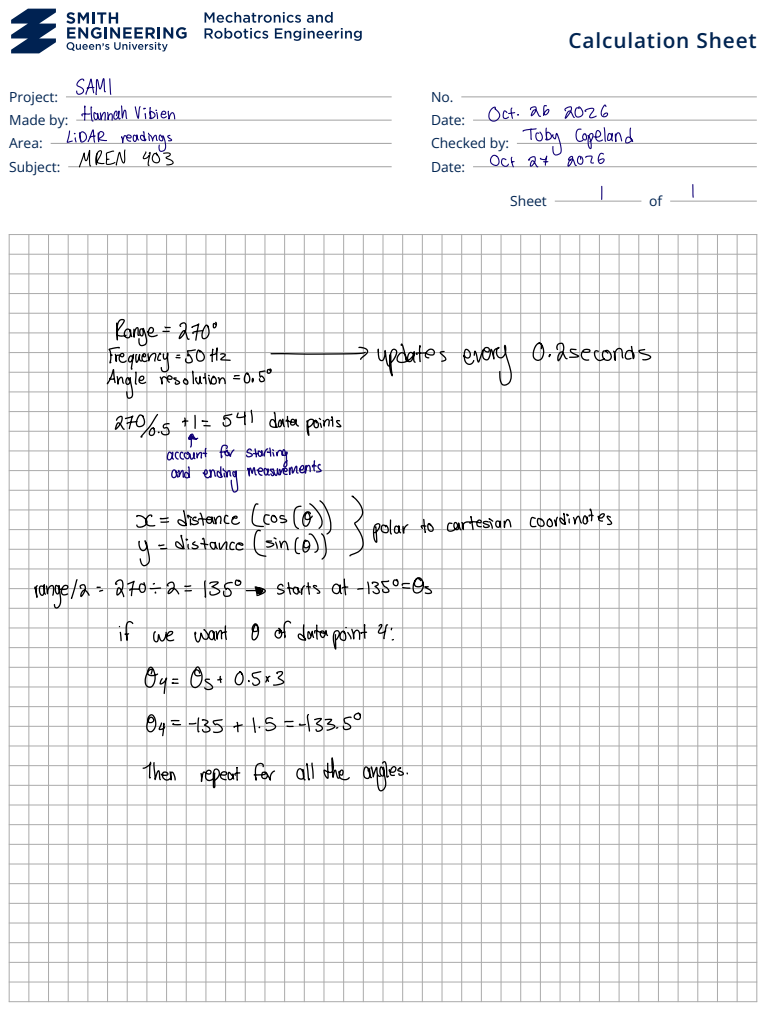
[picture p36: page 1]
Project:; Made by:; Date:; Area:; Checked by:; Subject:; Sheet; HannahVibien; Oct ²⁶ 2026; LiDARreadings; TobyCopeland; MREN 403; Oct 27 2076; fjieij.sii; updates every; 0.2seconds

Angleresolution | | | | | | 05

2700.5 | | | | 1 | 541datapoints
aIements-JC
distance | | | | cos o | | polartocartesian coordinates
distance | sin o

aifintentn.gs

range2 | 270 | | | 2 | 135 | | | startsat 1350 0

if | we want | | | | 0 ofdatapoint4
Oy Os 0.5 3
04 | | | 135 | | 1 5 | | 133.50

Then | | | repeatfor | | | | alltheangles
