itsNairr/SAMI/deliverables/Storyboard of SAMI.pdf

2D Side | I
me | ie

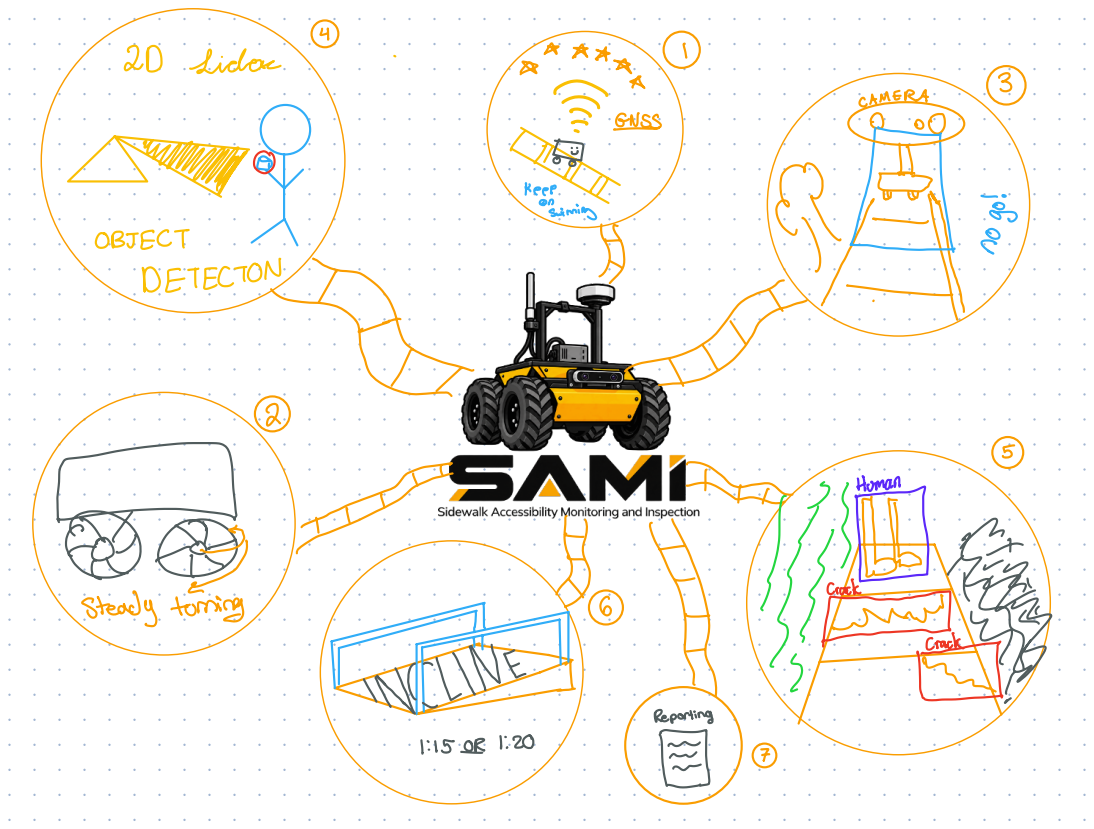
[picture p37: page 1]
GNSS; qfifif; OBJEGETECTONII; F.FMifnE; gg Steadyturning; WELINE
