itsNairr/SAMI/(commit log)

2026-11-05 Initial commit for main repo
    [034991-GEO_2.STEP, Group Tasks.xlsx, IC-Risk-Register-Template-Example.xlsx, RiskRegisterMatrix.xlsx]
2026-11-05 File organization
    [IC-Risk-Register-Template-Example.xlsx, RiskRegisterMatrix.xlsx]
2026-11-12 Ready for Portfolio I review
    [Book.xlsx, Collision avoidance data 2026-11-11.xlsx, Group Tasks.xlsx, HuskyA200.STEP, IC-Risk-Register-Template-Example.xlsx, IntelRealsense_D435_Multibody.SLDPRT, RiskRegisterMatrix.xlsx, SAMIRiskRegister.xlsx]
